akshar001/terraSpray/hardware/11_Terra Spray/Project Outputs for Terra_Spray/07_BOM/BOM/Bill of Materials-Terra_Spray.xlsx

Iteam No. | Designator | Description | Value | Manufacturer Part Number | Footprint | Case/Package | Quantity | Total Quantity Shipped | Quantity to be used in 512 PCB
1 | U1 | IC REG BOOST ADJ 3A SYNC 8MSOP |  | PAM2401SCADJ | 8-TSSOP, 8-MSOP | MSOP-8 | 1 | 4995 | 512
2 | S2 | 3mm Square Plunger 50mA Top触动 3.5mm SPST 12V SMD Tactile Switches ROHS |  | TS-1809SM-C | 434153017835 |  | 1 | 5000 | 512
3 | U3 | SERIAL TIME CHIP 8PIN, SOIC |  | DS1307Z+ | SOIC-8 | SOIC | 1 | 5000 | 512
4 | Q2 | Bipolar Transistors - BJT SOT-23 NPN |  | MMBT3904 | SOT-23 | SOT-23 | 1 | 5800 | 512
5 | Q3 | ON SEMICONDUCTOR - MMBT3906LT1G - Bipolar (BJT) Single Transistor, General Purpose, PNP, -40 V, 250 MHz, 225 mW, -200 mA, 300 hFE |  | MMBT3906 | SOT-23 | SOT-23-3 | 1 | 5900 | 512
6 | Q1 | Trans MOSFET N-CH 20V 3.2A 6-Pin SC-88 T/R |  | NTJS3157NT1G | SOT-363 | SOT-363-6 | 1 | 6000 | 512
7 | C6, C14, C15 | Ceramic Capacitor,10uF,0603,10V | 10uF |  | CAPC0603 | 0603 | 3 | 16000 | 1536
8 | C1, C2, C3 | Ceramic Capacitor,22uF,0603,6.3V | 22uF |  | CAPC0603 | 0603 | 3 | 16000 | 1536
9 | X1 | 40MHz ±10ppm 10pF 30Ω SMD-3225 SMD Crystal Resonators RoHS |  |  | Crystal_3225 | SMD-3225 | 1 | 5900 | 512
10 | D1 | CGRM4007-G; SMT Diode; 1000V 1A; 2-Pin SOD-123 |  | CGRM4007-G | SOD-123 | SOD-123-2 | 1 | 6000 | 512
11 | D2, D3 | Diode Schottky 40V 0.5A 2-Pin SOD-123 T/R |  | B0540W | SOD123 | SOD123 | 2 | 5300 | 1024
12 | R11 | Thick Film Resistor - 220Kohm, 1%, 0603 | 220K |  | RESC0603 | 0603 | 1 | 5000 | 512
13 | R12 | Thick Film Resistor - 309Kohm, 1%, 0603 | 309K |  | RESC0603 | 0603 | 1 | 5000 | 512
14 | R5, R7, R8, R9, R10 | Thick Film Resistor - 10Kohm, 1%, 0402 | 10K |  | RESC0402 | 0402 | 5 | 30000 | 2560
15 | R3 | Thick Film Resistor - 100ohm, 1%, 0603 | 100E |  | RESC0603 | 0603 | 1 | 5000 | 512
16 | R2, R4 | Thick Film Resistor - 100Kohm, 1%, 0603 | 100K |  | RESC0603 | 0603 | 2 | 10000 | 1024
17 | R1 | Thick Film Resistor - 453Kohm, 1%, 0603 | 453K |  | RESC0603 | 0603 | 1 | 5000 | 512
18 | L2 | 2nH ±0.3nH 900mA 120mΩ 0402 Inductors (SMD) RoHS |  | MLG1005S2N0BT000 | inductor 0402 | 0402 | 1 | 6400 | 512
19 | C4, C5 | Ceramic Capacitor,22pF,0402,50V | 22pF |  | capc0402 | 0402 | 2 | 10000 | 1024
20 | C7 | Ceramic Capacitor,1uF,0402,6.3V | 1uF |  | CAPC0402 | 0402 | 1 | 7000 | 512
21 | C8, C9, C10, C11, C16, C17, C18, C19, C20, C21, C24, C25, C26 | Ceramic Capacitor,100nF,0402,6.3V | 100nF |  | CAPC0402 | 0402 | 13 | 65000 | 6656
22 | R6 | Thick Film Resistor - 820ohm, 1%, 0603 | 820E |  | RESC0603 | 0603 | 1 | 8000 | 512
23 | L3 | Thick Film Resistor - 0ohm, 1%, 0402 | 0E |  | inductor 0402 | 0402 | 1 | 600 | 512
24 | L1 | SMD Power Inductors ROHS | 2.2uH | FNR5012S2R2MT | INDP5050X20N |  | 1 | 5000 | 512
25 | U2 | WiFi 802.11b/g/n Transceiver Module 2.4GHz |  | ESP32-S2FH4 | QFN56-7x7mm | QFN-56 | 1 | 512 | 512
26 | S3 | Pushbutton 6x6mm, Actuator Height off PCB, Vertical 9.50mm |  | TC-06104-E | FSMJ - SMD - Wifi |  | 1 | 300 | 512
