akshar001/terraSpray/hardware/11_Terra Spray/Project Outputs for Terra_Spray/04_3D_Files/ExportSTEP/Terra_Spray.step

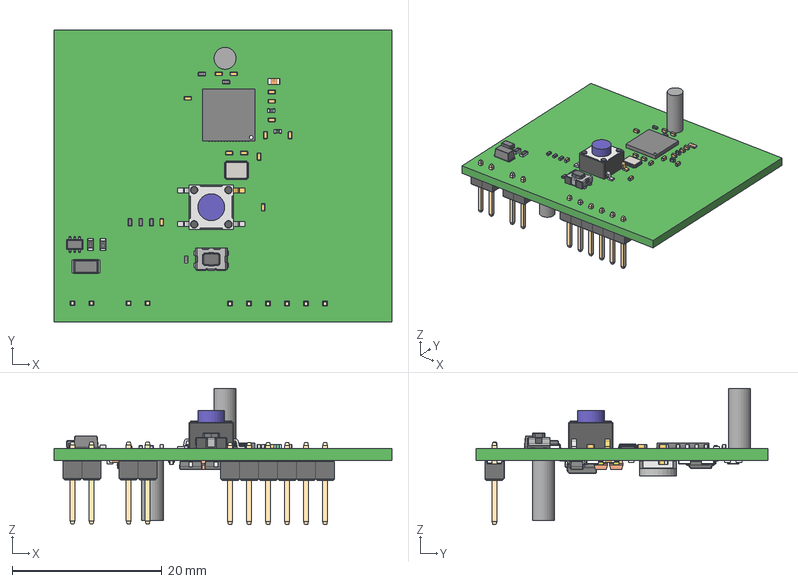
[picture p1: CAD file, 2022-03-02]
hardware/11_Terra Spray/Project Outputs for Terra_Spray/04_3D_Files/ExportSTEP/Terra_Spray.step
45.2 x 39.0 x 18.2 mm
R0402 x 6
0603_SMD_Capacitor x 6
User_Library-tsx-3225
SMD_R-0603 x 7
SOT23-3 x 2
LQG15HN2N0S02D x 2
SOD-123 x 2
CAPC1005X56N_EIA_0402 x 20
Open_CASCADE_STEP_translator_6.8_71.1
Open_CASCADE_STEP_translator_6.8_71.2.1
Leader x 22
User_Library-switch
User_Library-QFN56_0_4
Open_CASCADE_STEP_translator_6.8_10.3.1 x 2
Open_CASCADE_STEP_translator_6.8_8.1
Open_CASCADE_STEP_translator_6.8_8.2.1
Open_CASCADE_STEP_translator_6.8_5.1.1
Open_CASCADE_STEP_translator_6.8_19.1.1
lead x 2
User_Library-Header1x2_Header1_1 x 10
Button
Boitier
Tole
Pads
