akshar001/terraSpray/hardware/11_Terra Spray/Project Outputs for Terra_Spray/03_PDF_Files/Schematic Print/Schematic Print.PDF

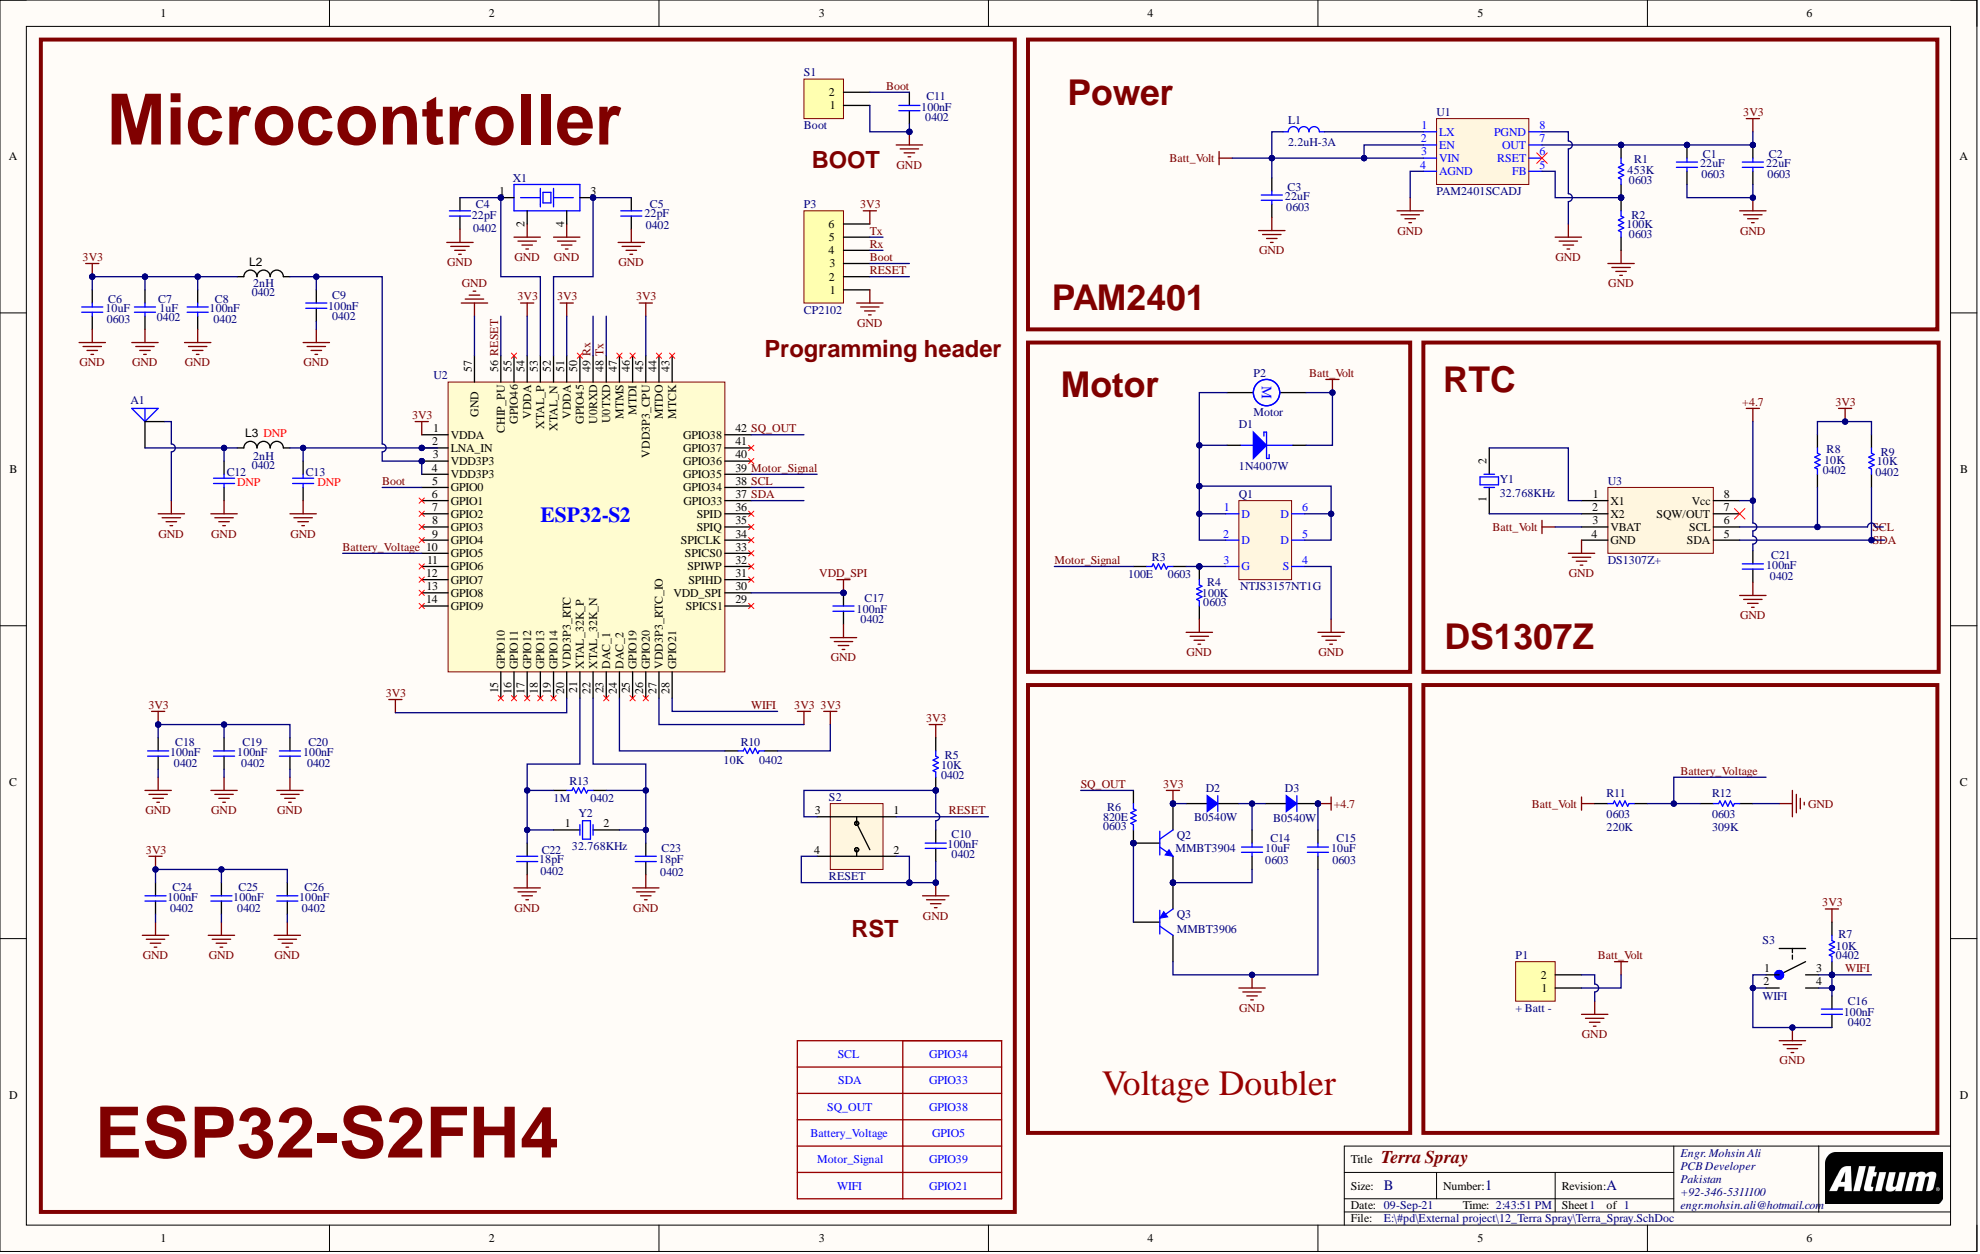
[picture p2: page 1]

MTCK 43 MTDO 44 VDD3P3_CPU 45 MTDI 46 MTMS 47 U0TXD 48 U0RXD 49 GPIO45 50 VDDA 51 XTAL_N 52 XTAL_P 53 VDDA 54 GPIO46 55 CHIP_PU 56

SCL | GPIO34

SDA | GPIO33

SQ_OUT | GPIO38

Battery_Voltage | GPIO5

Motor_Signal | GPIO39

E:\#pd\External project\12_Terra Spray\Terra_Spray.SchDoc
