akshar001/terraSpray/hardware/11_Terra Spray/assembly files terra spray/PCB Print.PDF

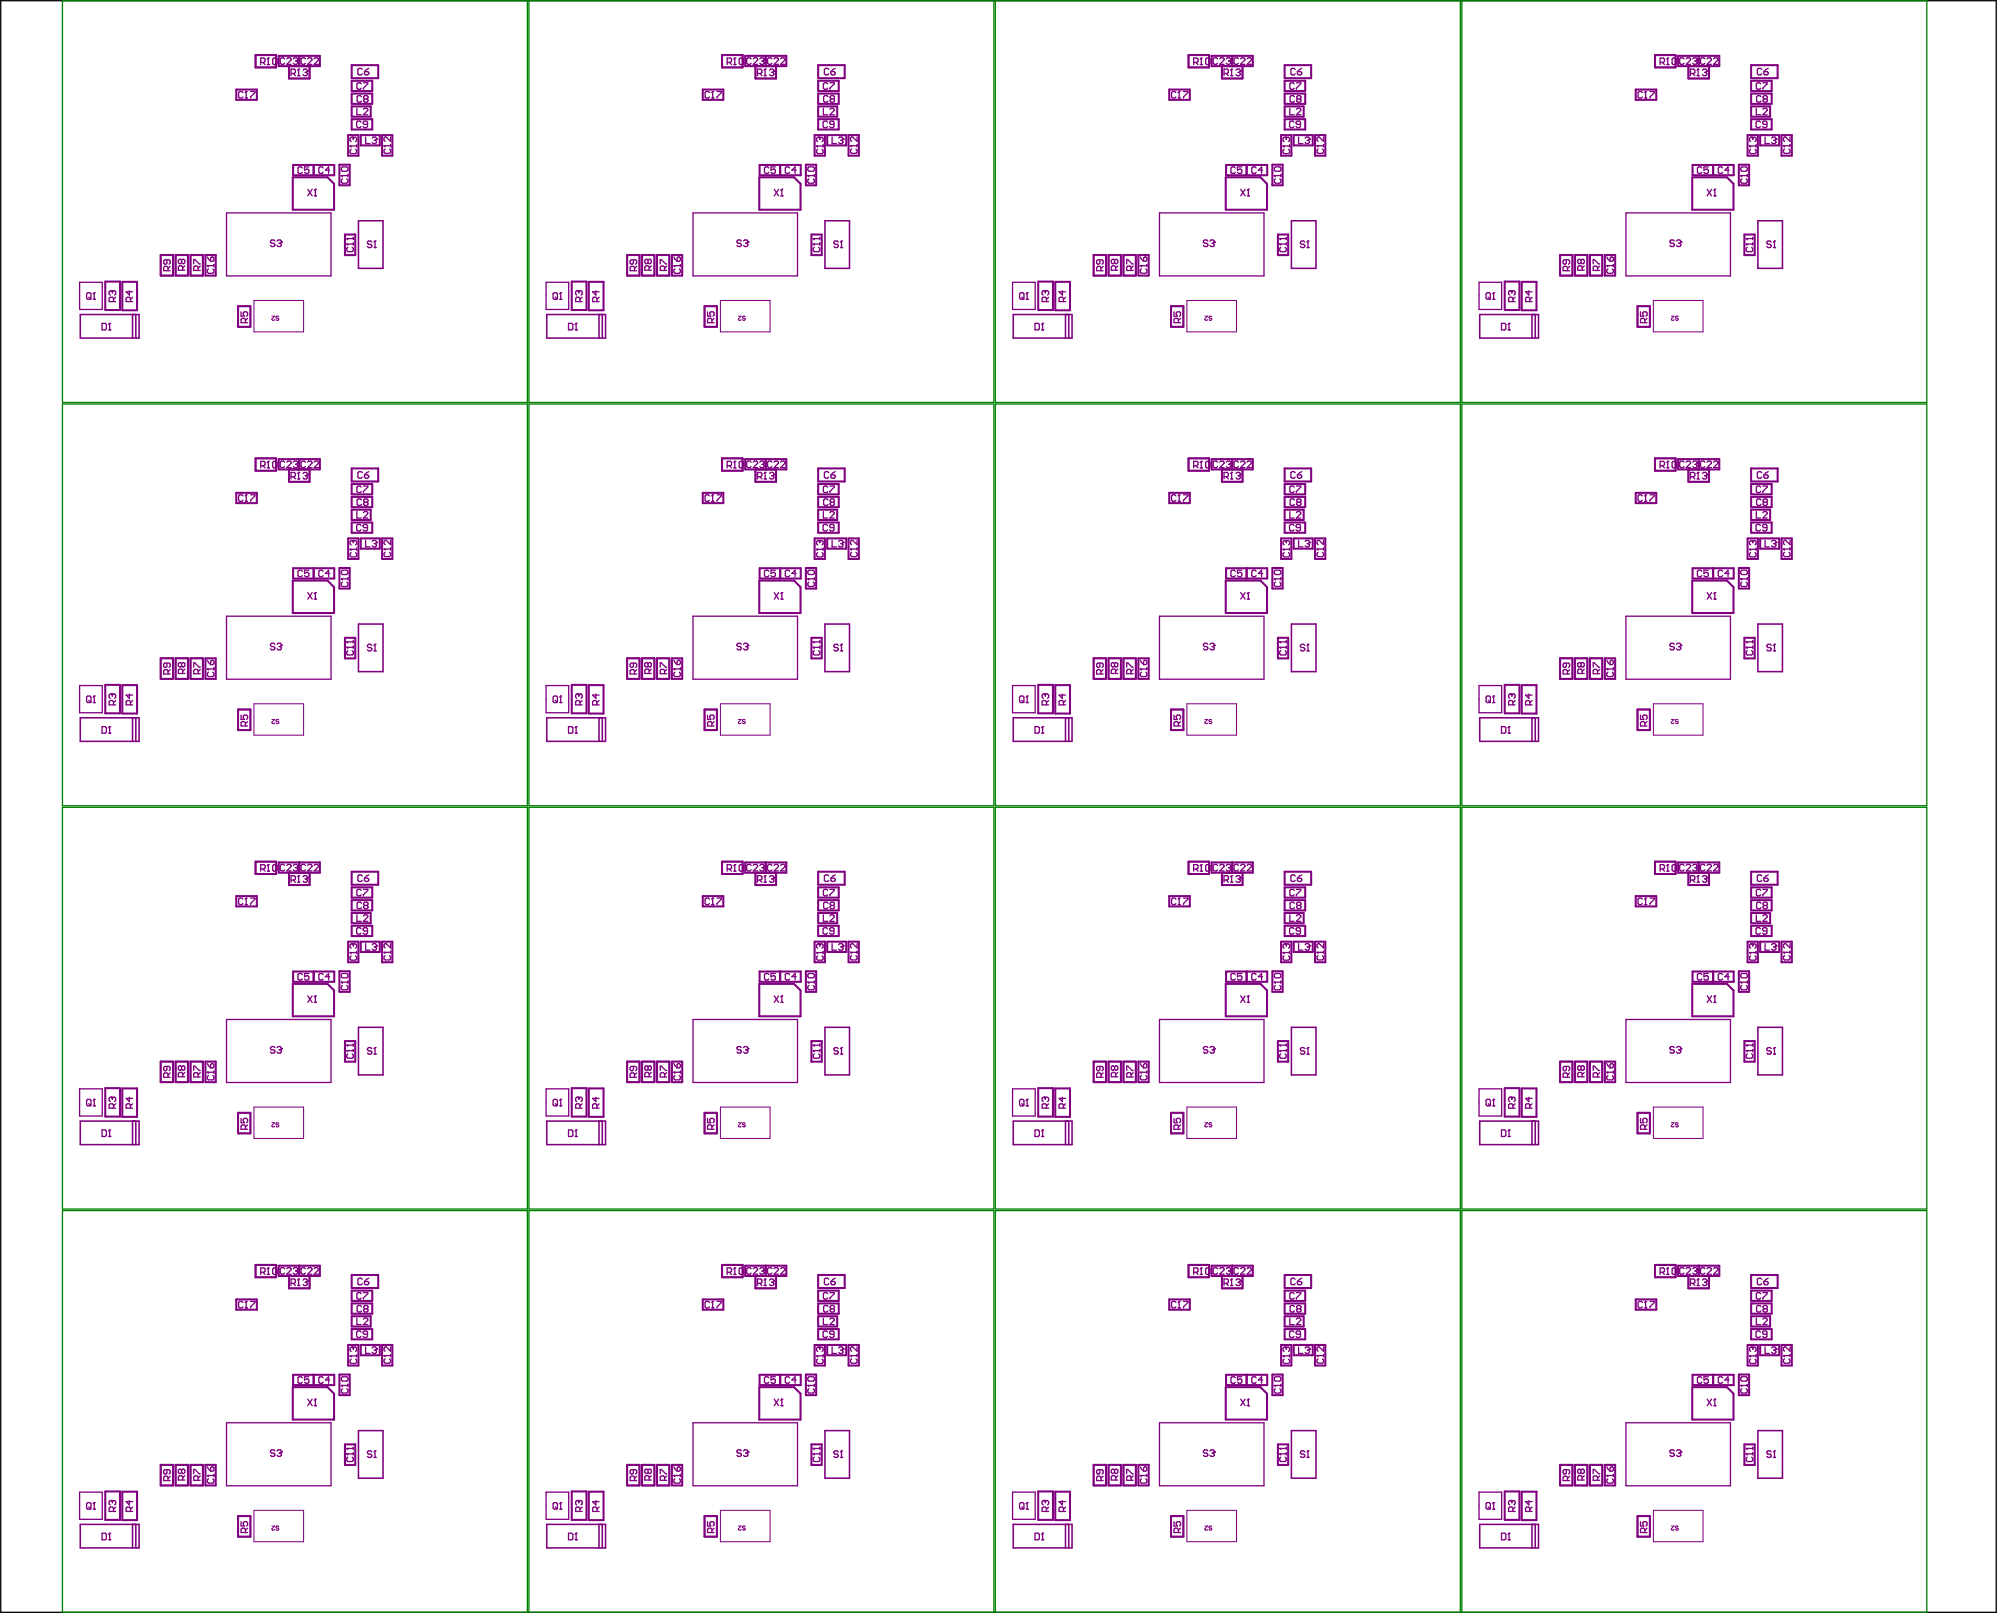
[picture p3: page 1]

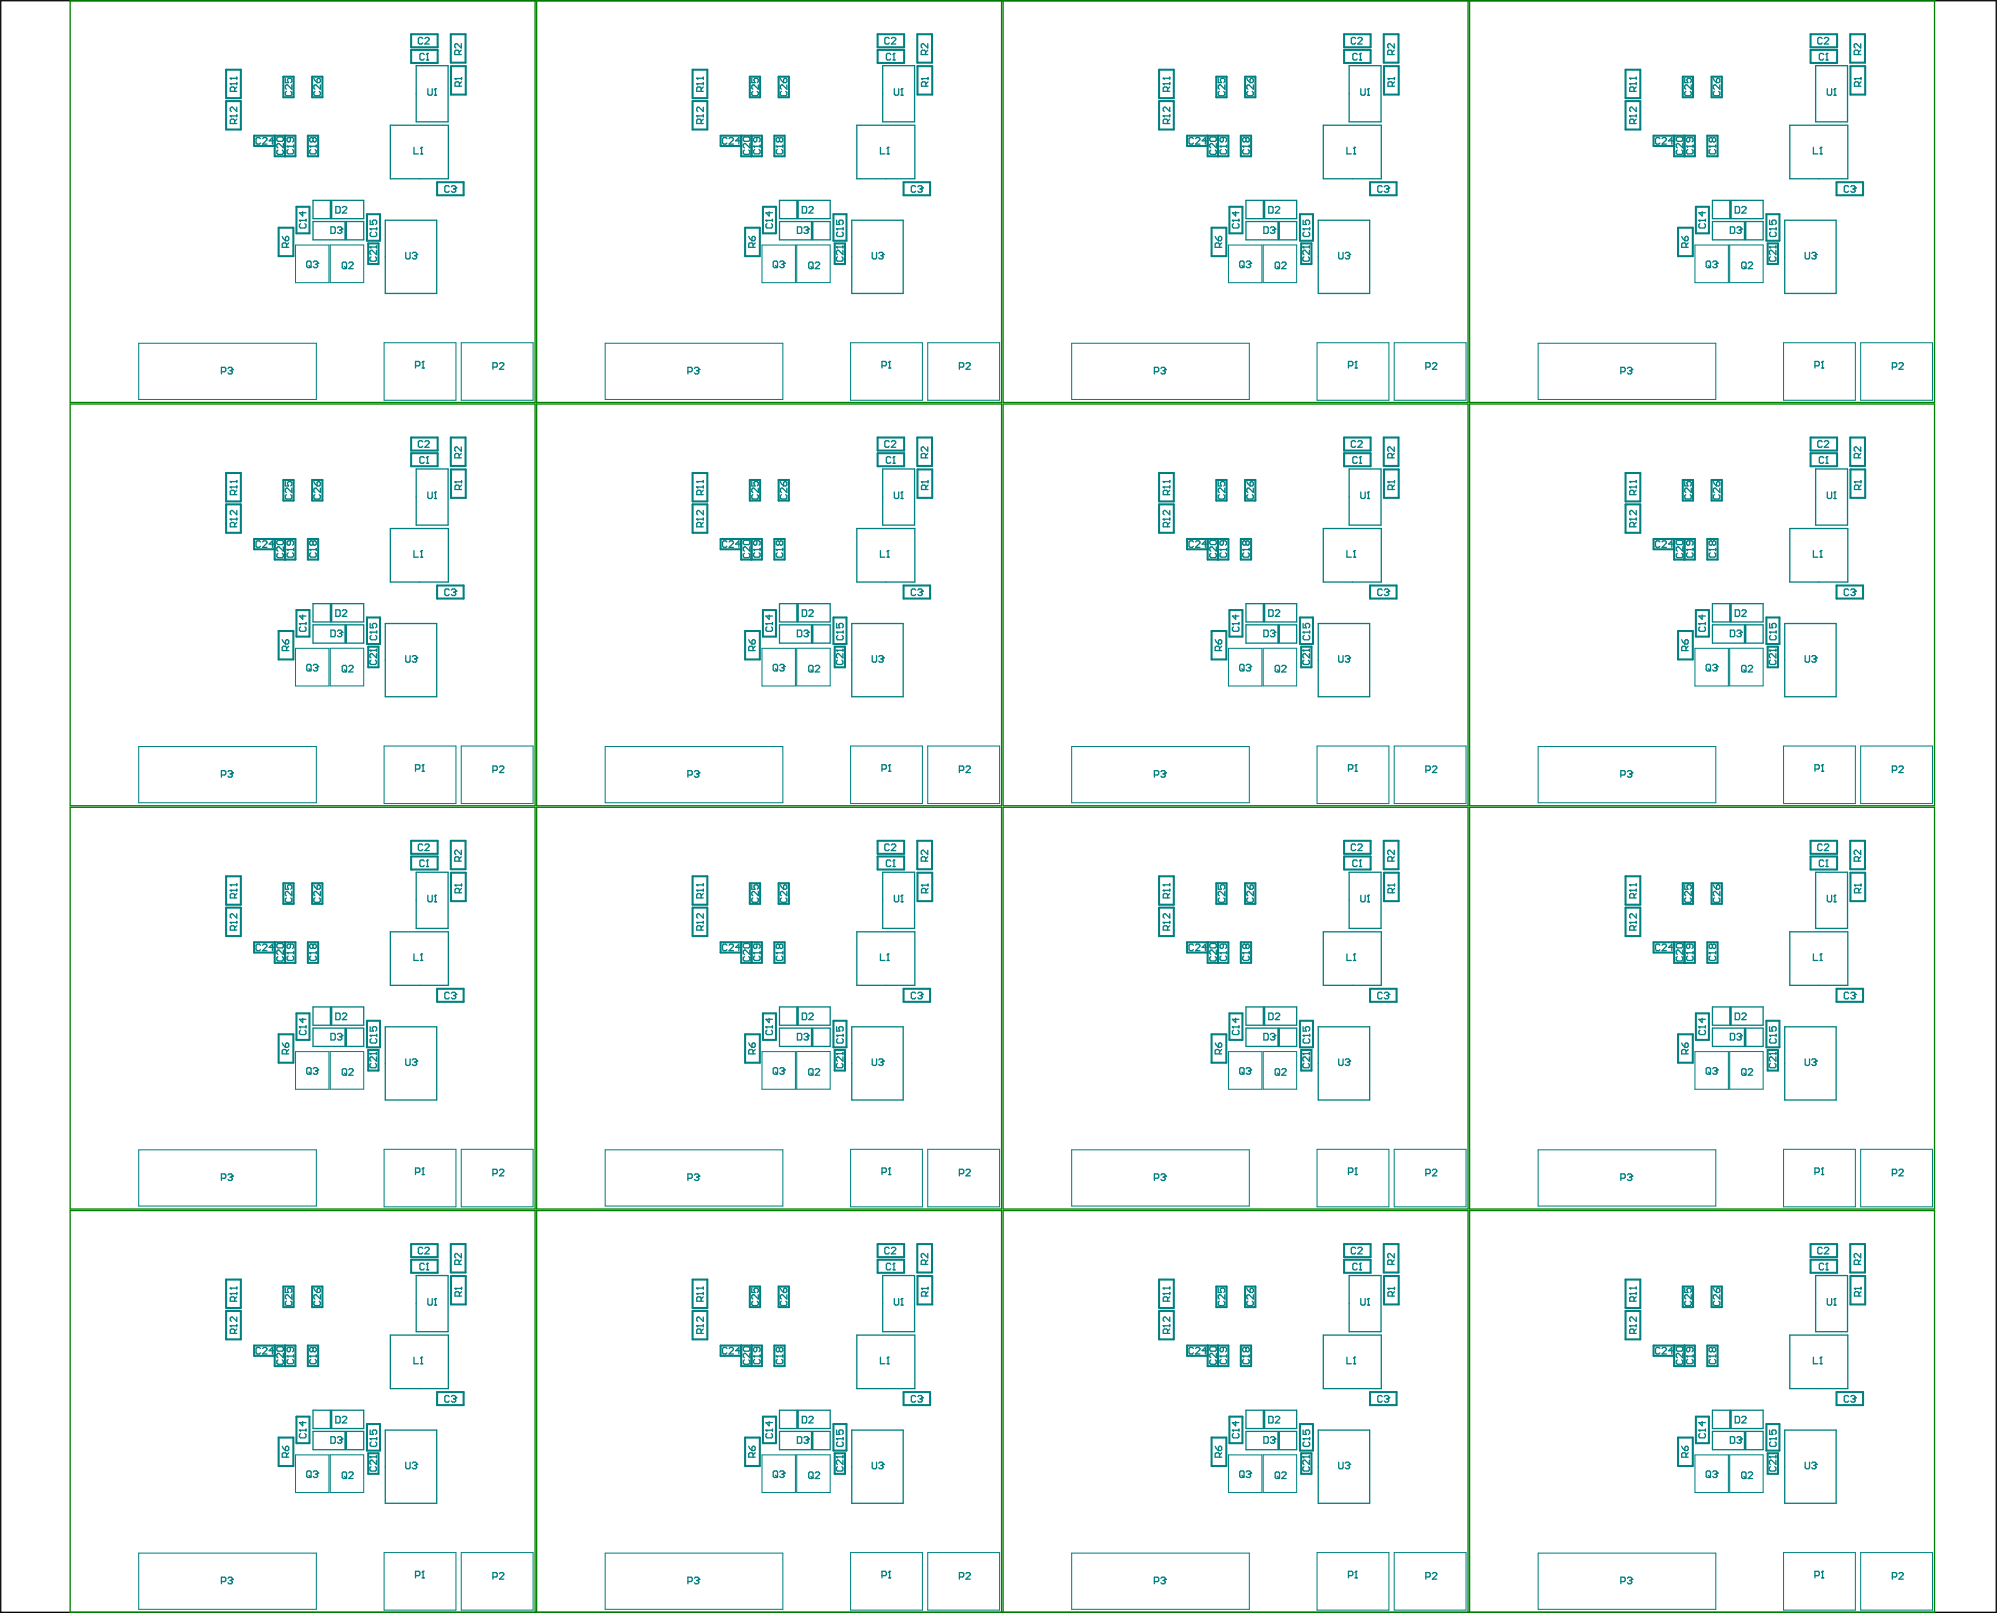
[picture p4: page 2]
