akshar001/terraSpray/hardware/11_Terra Spray/Project Outputs for Terra_Spray/02_Assembly_Drawings single/PCB Print/PCB Print.PDF

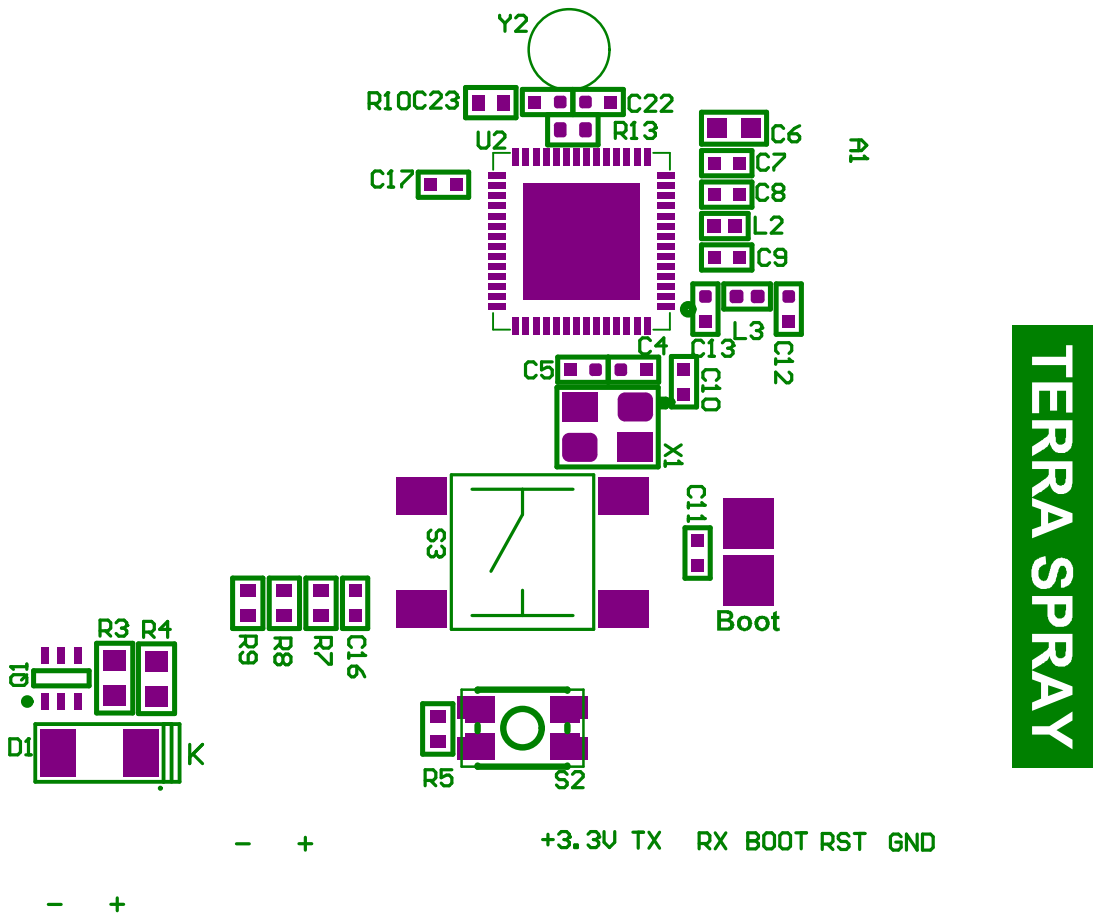
[picture p5: page 1]

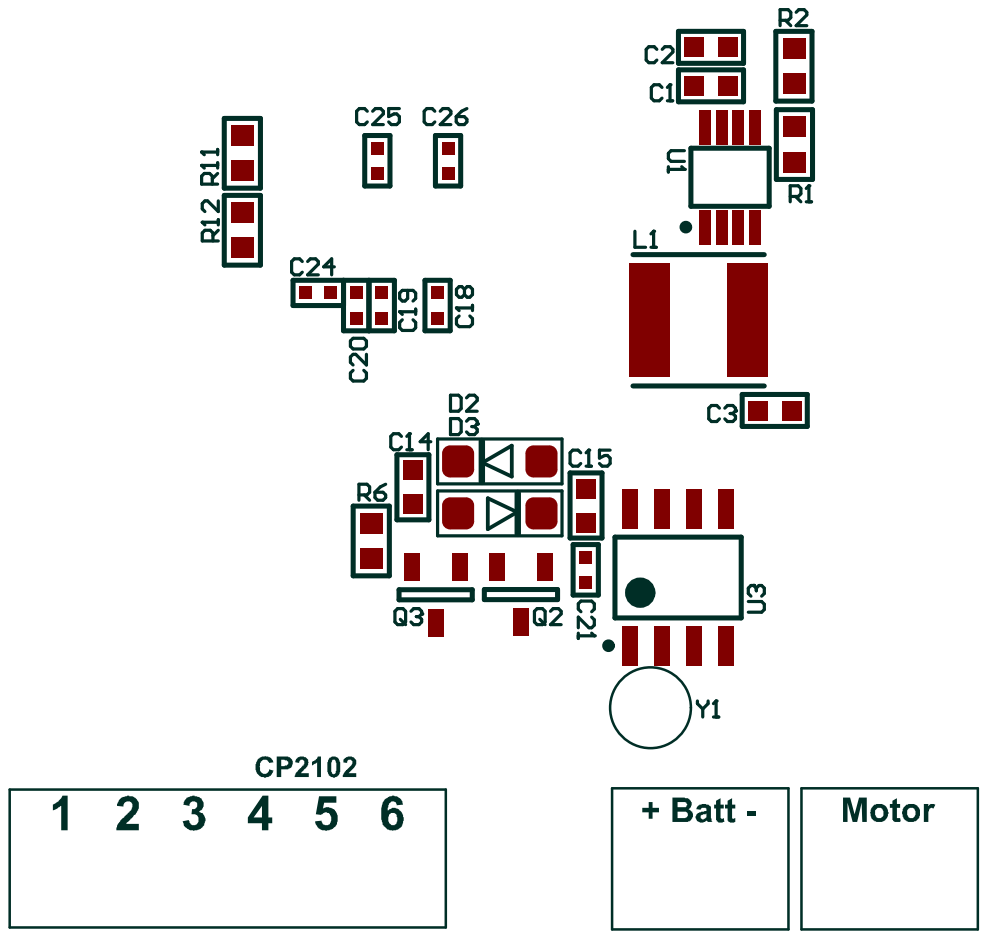
[picture p6: page 2]
