akshar001/terraSpray/(list of files, drawings)

Other design files:
hardware/11_Terra Spray/Project Outputs for Terra_Spray/06_Design_Files/Copy Files/OutOfProjectDir/Pd's Sch Lib.SchLib
hardware/11_Terra Spray/Project Outputs for Terra_Spray/06_Design_Files/Copy Files/Terra_Spray.PcbDoc
hardware/11_Terra Spray/Project Outputs for Terra_Spray/06_Design_Files/Copy Files/Terra_Spray.PcbLib
hardware/11_Terra Spray/Project Outputs for Terra_Spray/06_Design_Files/Copy Files/Terra_Spray.SchDoc
hardware/11_Terra Spray/Project Outputs for Terra_Spray/06_Design_Files/Copy Files/Terra_Spray.SCHLIB
hardware/11_Terra Spray/Terra Spray panel 16 pcb.PcbDoc
hardware/11_Terra Spray/Terra_Spray.PcbDoc
hardware/11_Terra Spray/Terra_Spray.PcbLib
hardware/11_Terra Spray/Terra_Spray.PrjPCB
hardware/11_Terra Spray/Terra_Spray.SchDoc
hardware/11_Terra Spray/Terra_Spray.SCHLIB
